Nazg-Gul/NixieTracker/README.md

NixieTracker
============

This is a nixie tube based display for number of opened bugs in Blender tracker.

The hardware itself doesn't care at all which three digits it displays so it'll
be totally simple to adopt it to something else.
