Nazg-Gul/NixieTracker/Schematic.pdf

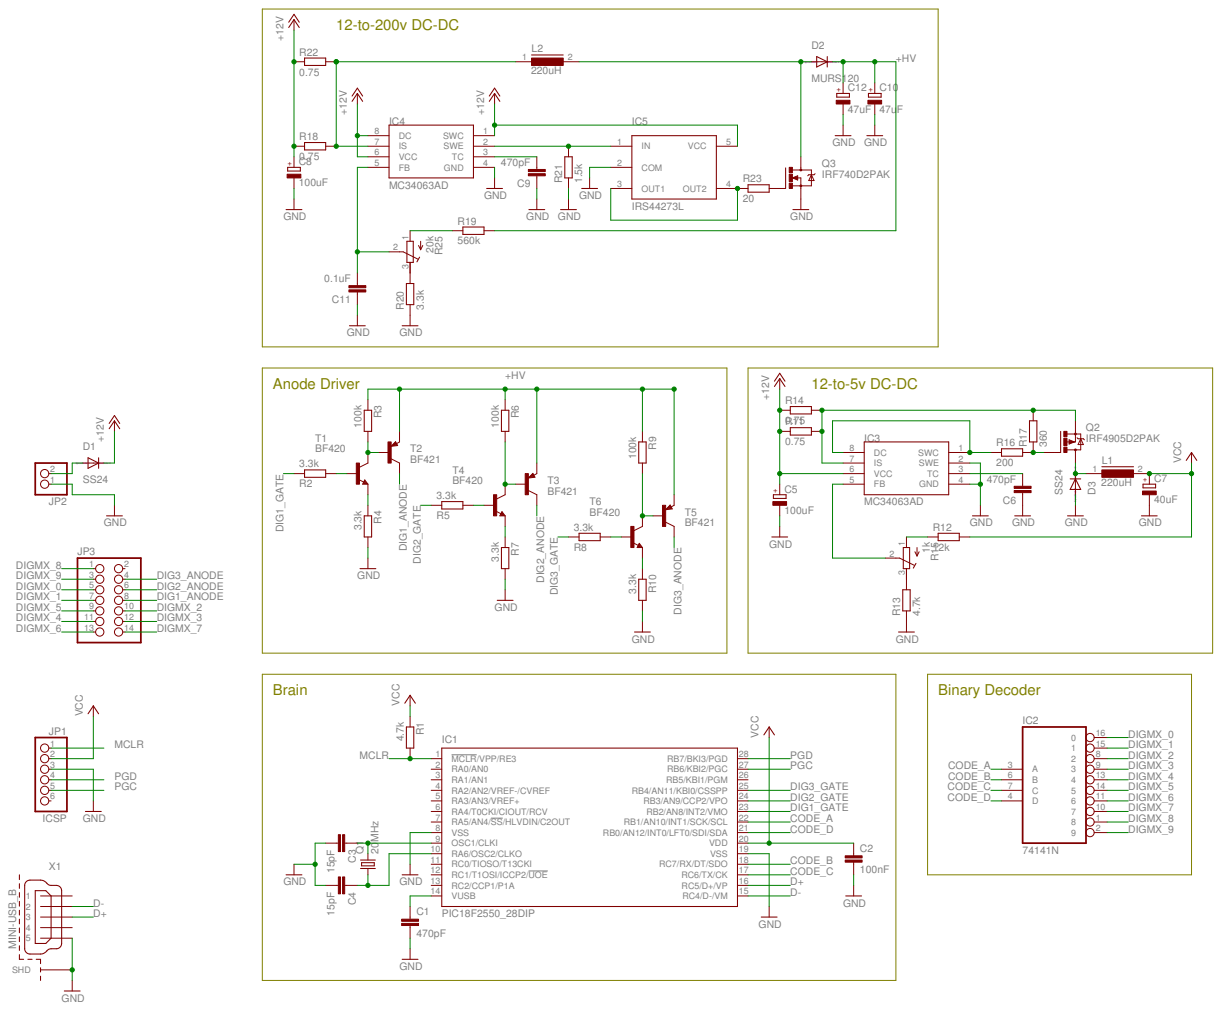
[picture p1: page 1]
