Nazg-Gul/NixieTracker/PCB.pdf

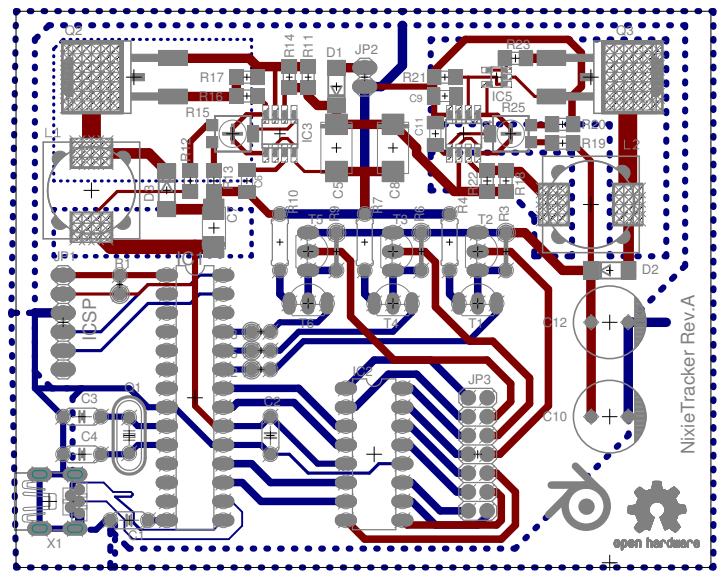
[picture p2: page 1]
