Nazg-Gul/NixieTracker/NixieTracker.brd

## EAGLE design NixieTracker.brd (2015-01-11)

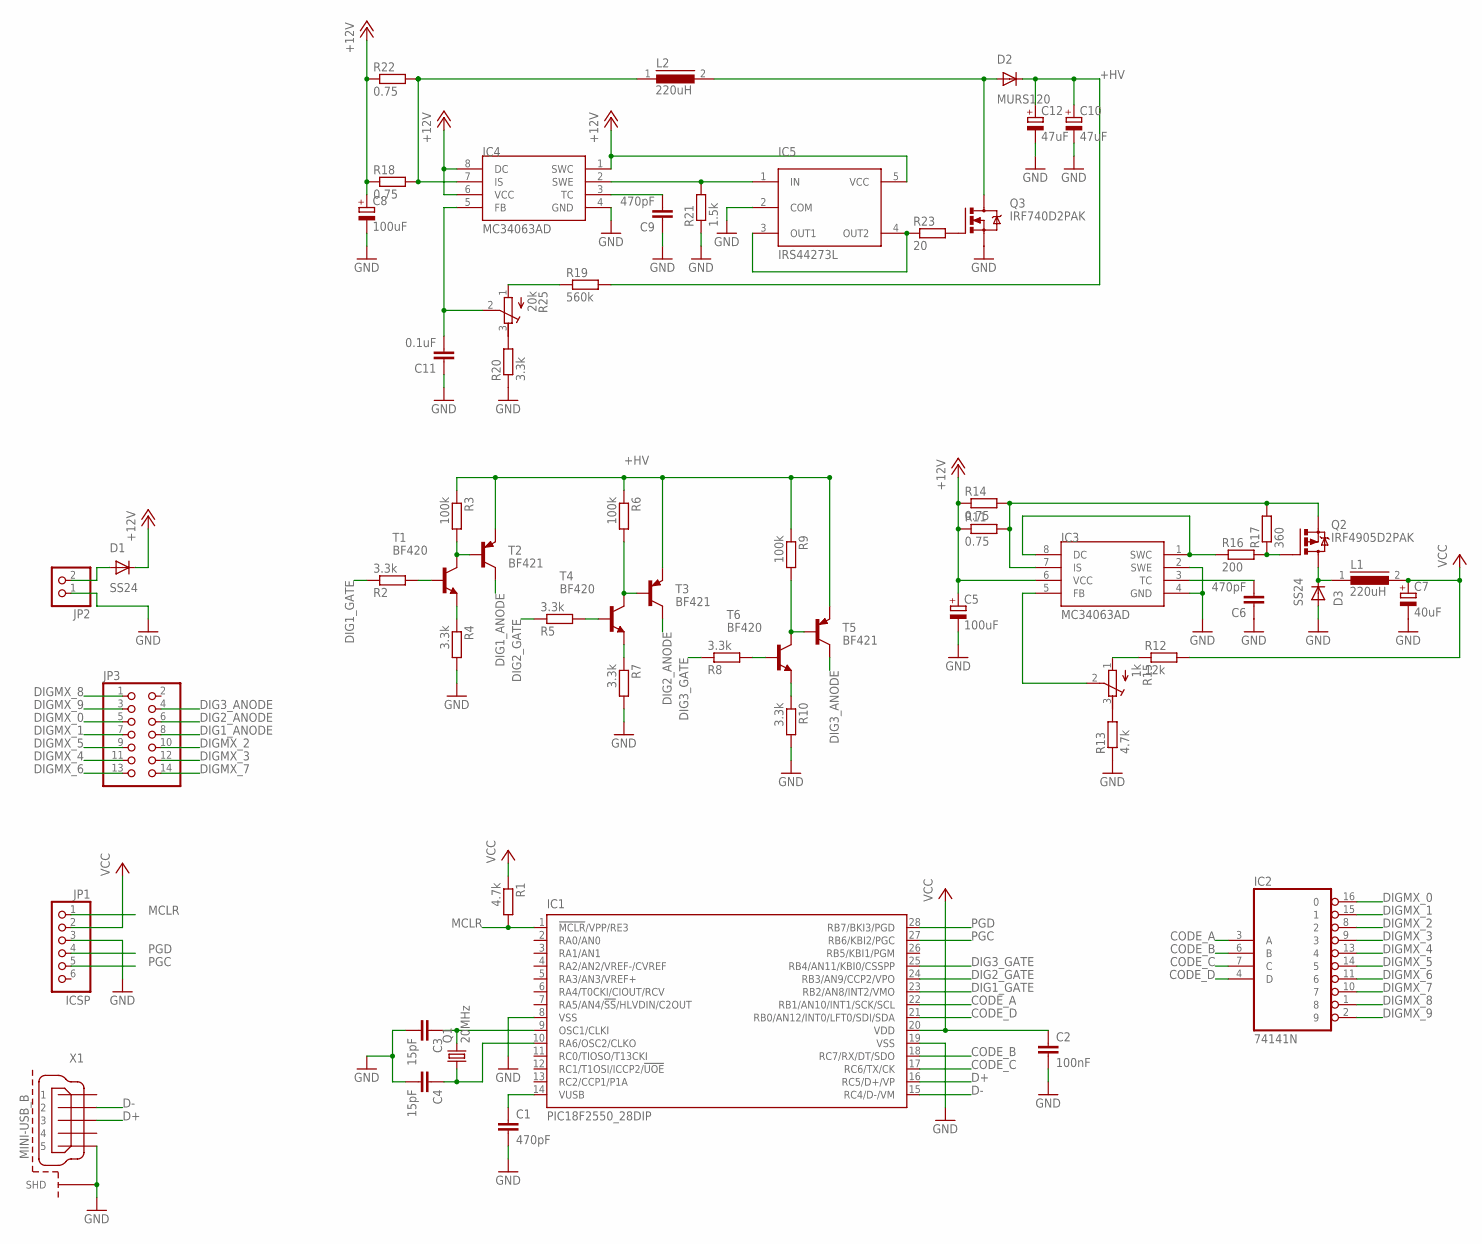
[picture p3: schematic NixieTracker.sch]

Parts:
C1: 470pF; C050-024X044
C2: 100nF; C050-024X044
C3, C4: 15pF; C050-024X044
C5, C8: 100uF; D/7343-31R
C6, C9: 470pF; C1206K
C7: 40uF; C/6032-28R
C10, C12: 47uF; SANYO-OSCON_F13
C11: 0.1uF; C1206K
D1, D3: SS24; DO214AA
D2: MURS120; DO214AA
IC1: PIC18F2550_28DIP; DIL28-3
IC2: 74141N; DIL16
IC3, IC4: MC34063AD; SOIC8
IC5: IRS44273L; SOT23-5
JP1: ICSP; 1X06
JP2: PINHD-1X2; 1X02
JP3: PINHD-2X7; 2X07
L1, L2: 220uH; DR125
Q1: 20MHz; HC49/S
Q2: IRF4905D2PAK; D2PAK
Q3: IRF740D2PAK; D2PAK
R1: 4.7k; 0207/2V
R2, R5, R8: 3.3k; 0207/2V
R3, R6, R9: 100k; 0207/5V
R4, R7, R10: 3.3k; 0207/7
R11, R14, R18, R22: 0.75; R1206
R12: 12k; R1206
R13: 4.7k; R1206
R15: 1k; RTRIM4G/J
R16: 200; R1206
R17: 360; R1206
R19: 560k; R1206
R20: 3.3k; R1206
R21: 1.5k; R1206
R23: 20; R1206
R25: 20k; RTRIM4G/J
T1, T4, T6: BF420; TO92-ECB
T2, T3, T5: BF421; TO92-ECB
X1: MINI-USB_B; MINI-USB-B

Connections:
+12V: C5.+, C8.+, D1.C, IC3.6 (VCC), IC4.1 (SWC), IC4.6 (VCC), IC4.8 (DC), IC5.5 (VCC), R11.1, R14.1, R18.1, R22.1
+HV: C10.+, C12.+, D2.C, R3.1, R6.1, R9.1, R19.2, T2.E, T3.E, T5.E
CODE_A: IC1.22 (RB1/AN10/INT1/SCK/SCL), IC2.3 (A)
CODE_B: IC1.18 (RC7/RX/DT/SDO), IC2.6 (B)
CODE_C: IC1.17 (RC6/TX/CK), IC2.7 (C)
CODE_D: IC1.21 (RB0/AN12/INT0/LFT0/SDI/SDA), IC2.4 (D)
D+: IC1.16 (RC5/D+/VP), X1.3
D-: IC1.15 (RC4/D-/VM), X1.2
DIG1_ANODE: JP3.8, T2.C
DIG1_GATE: IC1.23 (RB2/AN8/INT2/VMO), R2.1
DIG2_ANODE: JP3.6, T3.C
DIG2_GATE: IC1.24 (RB3/AN9/CCP2/VPO), R5.1
DIG3_ANODE: JP3.4, T5.C
DIG3_GATE: IC1.25 (RB4/AN11/KBI0/CSSPP), R8.1
DIGMX_0: IC2.16 (0), JP3.5
DIGMX_1: IC2.15 (1), JP3.7
DIGMX_2: IC2.8 (2), JP3.10
DIGMX_3: IC2.9 (3), JP3.12
DIGMX_4: IC2.13 (4), JP3.11
DIGMX_5: IC2.14 (5), JP3.9
DIGMX_6: IC2.11 (6), JP3.13
DIGMX_7: IC2.10 (7), JP3.14
DIGMX_8: IC2.1 (8), JP3.1
DIGMX_9: IC2.2 (9), JP3.3
GND: C1.2, C2.2, C3.2, C4.2, C5.-, C6.1, C7.-, C8.-, C9.1, C10.-, C11.1, C12.-, D3.A, IC1.8 (VSS), IC1.19 (VSS), IC2.12 (GND), IC3.2 (SWE), IC3.4 (GND), IC4.4 (GND), IC5.2 (COM), JP1.3, JP2.1, Q3.3 (S), R4.2, R7.2, R10.2, R13.1, R20.1, R21.1, X1.5, X1.M1 (SHD), X1.M2 (SHD), X1.M3 (SHD), X1.M4 (SHD)
MCLR: IC1.1 (!MCLR!/VPP/RE3), JP1.1, R1.2
unnamed: C1.1, IC1.14 (VUSB)
unnamed: C3.1, IC1.9 (OSC1/CLKI), Q1.2
unnamed: C4.1, IC1.10 (RA6/OSC2/CLKO), Q1.1
unnamed: R3.2, T1.C, T2.B
unnamed: R2.2, T1.B
unnamed: R4.1, T1.E
unnamed: R6.2, T3.B, T4.C
unnamed: R7.1, T4.E
unnamed: R5.2, T4.B
unnamed: R9.2, T5.B, T6.C
unnamed: R10.1, T6.E
unnamed: R8.2, T6.B
unnamed: C6.2, IC3.3 (TC)
unnamed: IC3.5 (FB), R15.2 (S)
unnamed: D2.A, L2.2, Q3.4 (D)
unnamed: D1.A, JP2.2
unnamed: D3.C, L1.1, Q2.4 (D)
unnamed: IC3.7 (IS), Q2.3 (S), R11.2, R14.2, R17.2
unnamed: Q2.1 (G), R16.2, R17.1
unnamed: IC3.1 (SWC), IC3.8 (DC), R16.1
unnamed: R13.2, R15.3 (E)
unnamed: R12.1, R15.1 (A)
unnamed: IC4.7 (IS), L2.1, R18.2, R22.2
unnamed: C9.2, IC4.3 (TC)
unnamed: C11.2, IC4.5 (FB), R25.2 (S)
unnamed: IC4.2 (SWE), IC5.1 (IN), R21.2
unnamed: Q3.1 (G), R23.2
unnamed: IC5.3 (OUT1), IC5.4 (OUT2), R23.1
unnamed: R19.1, R25.1 (A)
unnamed: R20.2, R25.3 (E)
PGC: IC1.27 (RB6/KBI2/PGC), JP1.5
PGD: IC1.28 (RB7/BKI3/PGD), JP1.4
VCC: C2.1, C7.+, IC1.20 (VDD), IC2.5 (VCC), JP1.2, L1.2, R1.1, R12.2

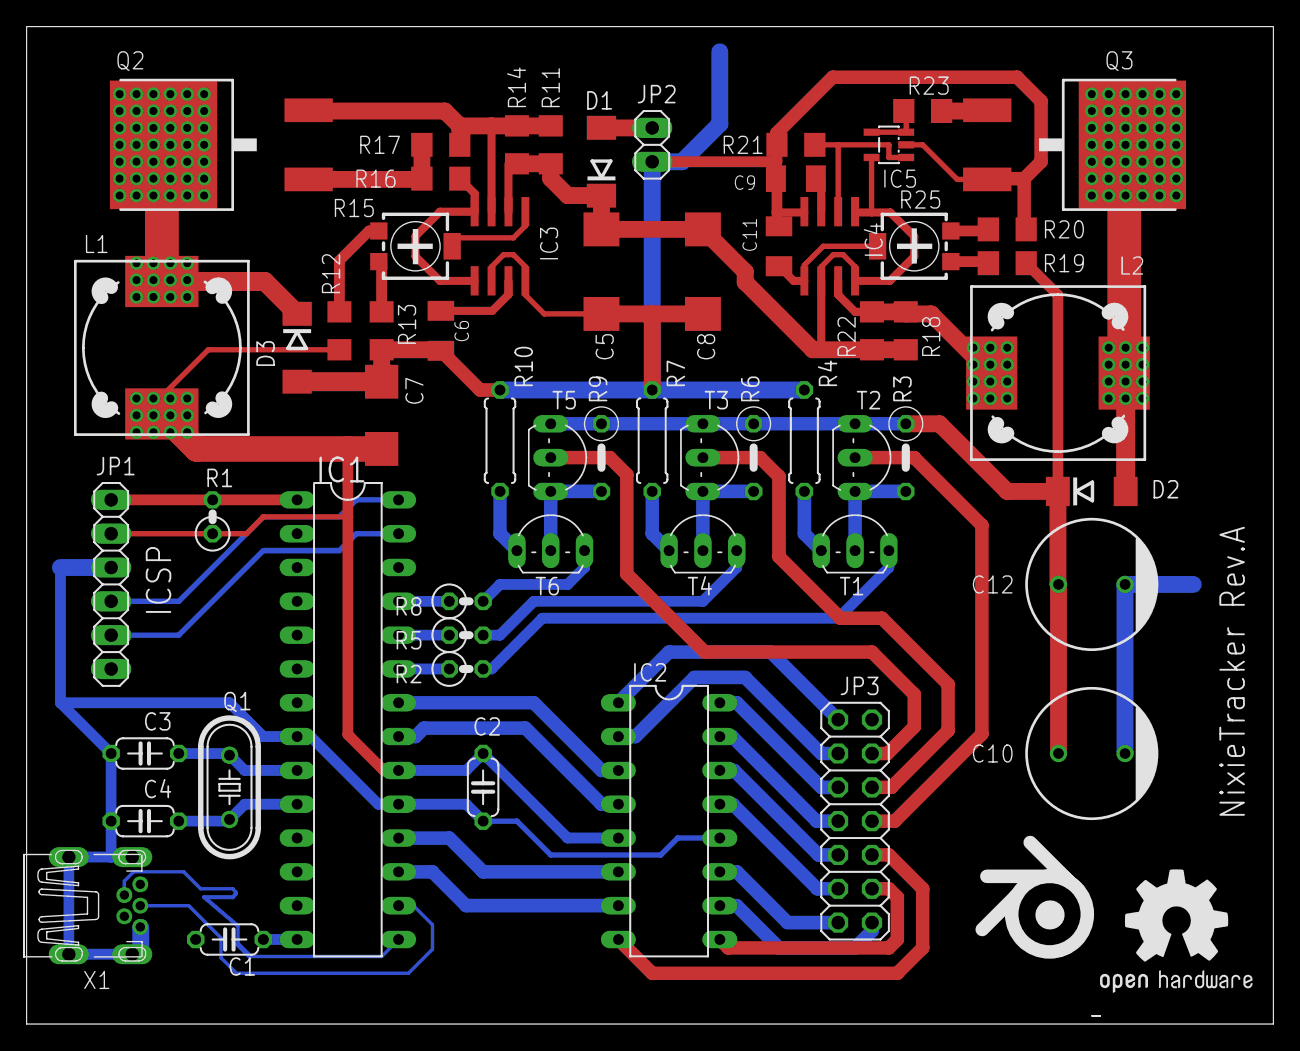
[picture p4: board NixieTracker.brd from above]

Board: 2 copper layers, 93.7 x 74.9 mm, 60 parts (0 on the bottom side), 59 nets.

Other parts of the board:
U$1: OSHW1
